nahhao74/Two-Wheels-Differential-Balance-Using-ROS2/solidwork/stm32f407-vet6-1.snapshot.2/stm32f407.jpg

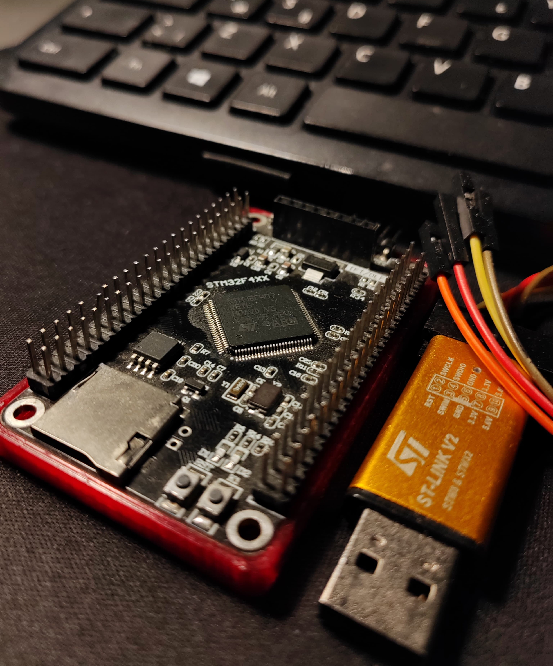
solidwork/stm32f407-vet6-1.snapshot.2/stm32f407.jpg
