nahhao74/Two-Wheels-Differential-Balance-Using-ROS2/README.md

# Two-Wheels-Differential-Balance-Using-ROS2
