nahhao74/Two-Wheels-Differential-Balance-Using-ROS2/imgs/twowheels_model.png

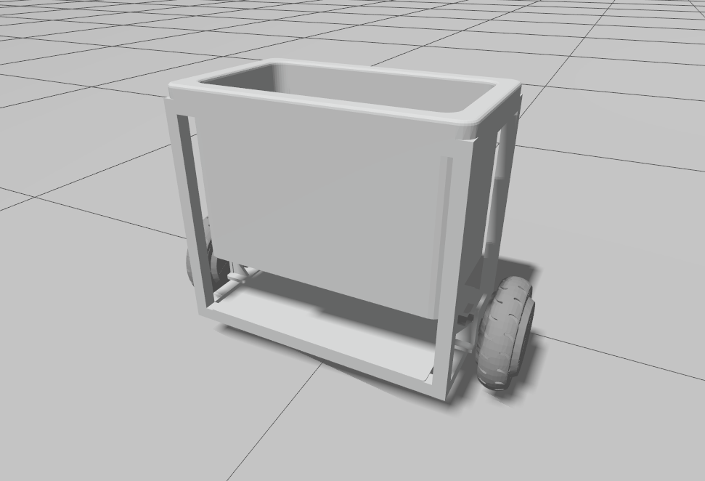
imgs/twowheels_model.png
