nahhao74/Two-Wheels-Differential-Balance-Using-ROS2/solidwork/zltech-zllg65asm250-v1-0-1.snapshot.4/messageImage_1767432714419.jpg

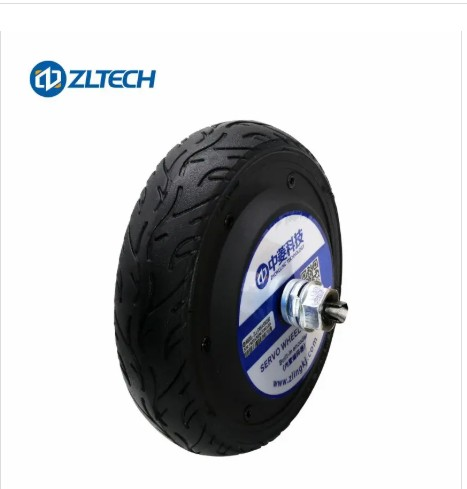
solidwork/zltech-zllg65asm250-v1-0-1.snapshot.4/messageImage_1767432714419.jpg
