nahhao74/Two-Wheels-Differential-Balance-Using-ROS2/solidwork/zltech-zllg65asm250-v1-0-1.snapshot.4/ZLLG65ASM250-V1.0.jpg

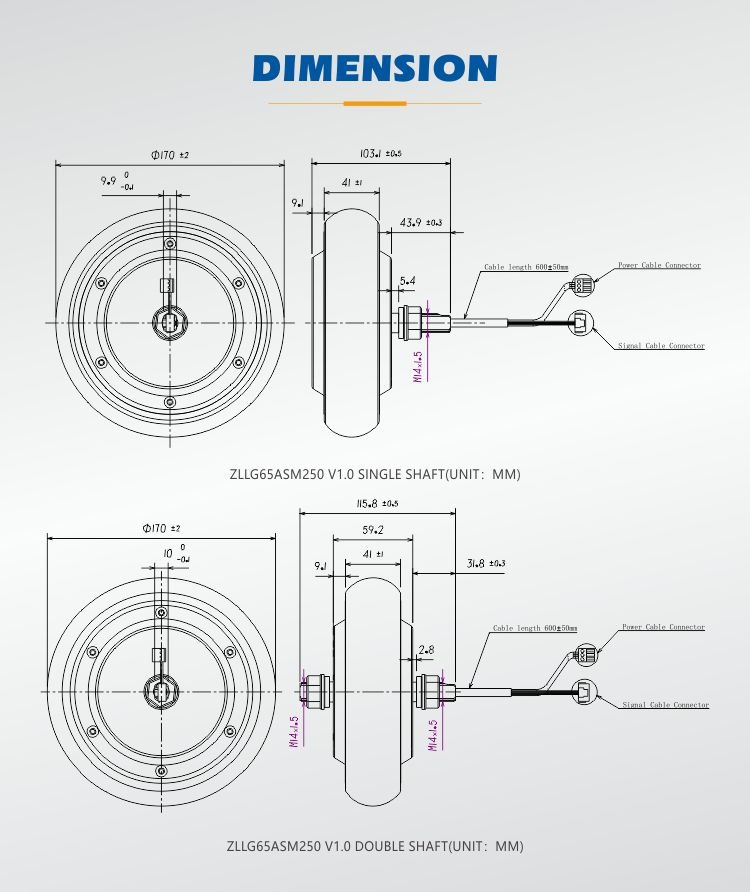
solidwork/zltech-zllg65asm250-v1-0-1.snapshot.4/ZLLG65ASM250-V1.0.jpg
