nahhao74/Two-Wheels-Differential-Balance-Using-ROS2/solidwork/zltech-zllg65asm250-v1-0-1.snapshot.4/ZLLG65ASM250 V1.0 DOUBLE SHAFT.STEP

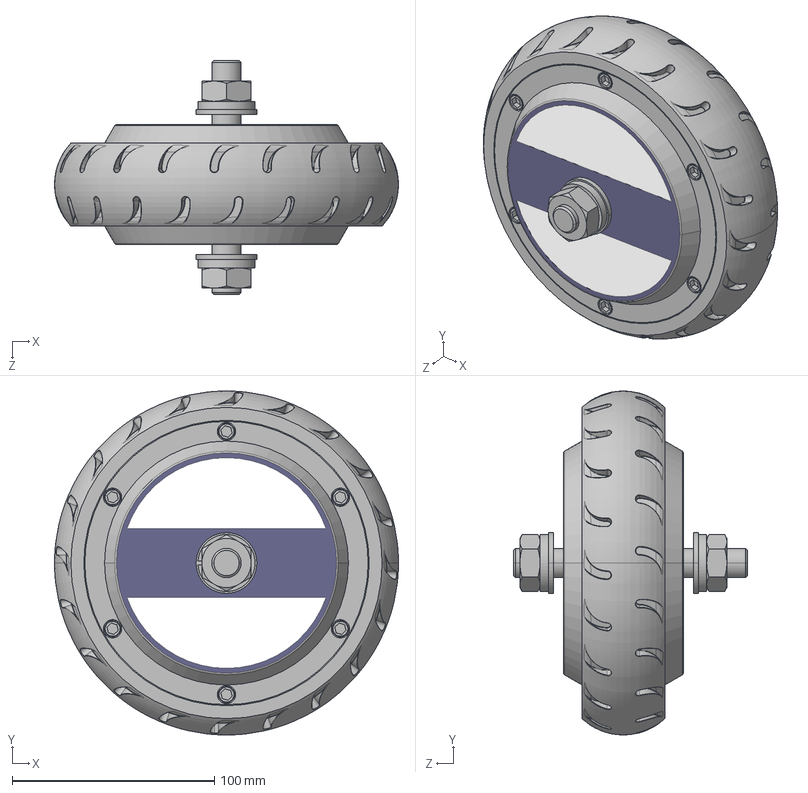
[picture p21: CAD file, 2026-07-22]
solidwork/zltech-zllg65asm250-v1-0-1.snapshot.4/ZLLG65ASM250 V1.0 DOUBLE SHAFT.STEP
170.0 x 170.0 x 115.8 mm
