nahhao74/Two-Wheels-Differential-Balance-Using-ROS2/solidwork/Cum_gia_do_khay.SLDASM

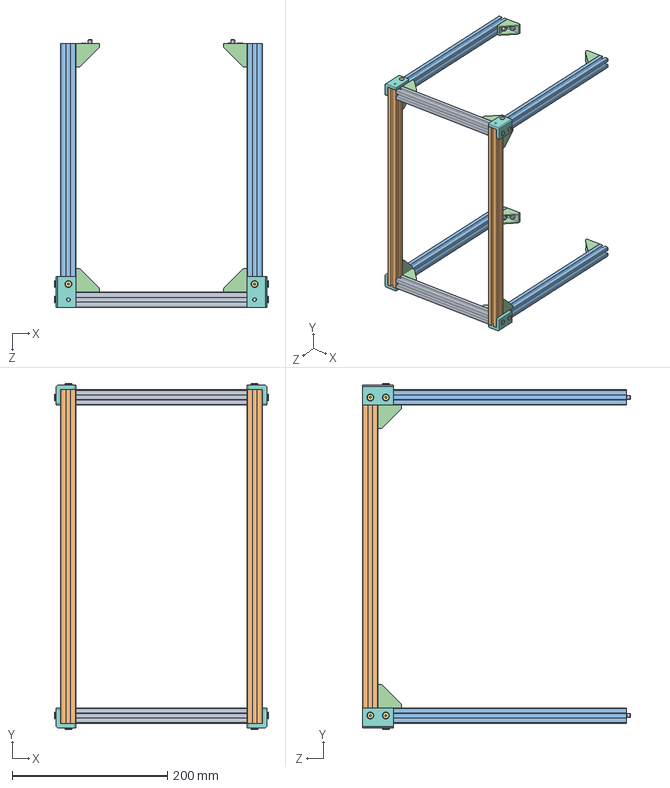
[picture p22: CAD file, 2026-07-22]
solidwork/Cum_gia_do_khay.SLDASM
276.0 x 446.0 x 345.3 mm
HFS5-2020-220 x 2
HFS5-2020-430 x 2
HFS5-2020-380 x 4
BRACKET_HBLFSN5 x 12
HNTT5-5 x 32
CSH-STU-M5-10 x 23
CBSTSE5-12 x 12
flat_bar x 4
