nahhao74/Two-Wheels-Differential-Balance-Using-ROS2/solidwork/zltech-zllg65asm250-v1-0-1.snapshot.4/ZLLG65ASM250 V1.0 SINGLE SHAFT.STEP

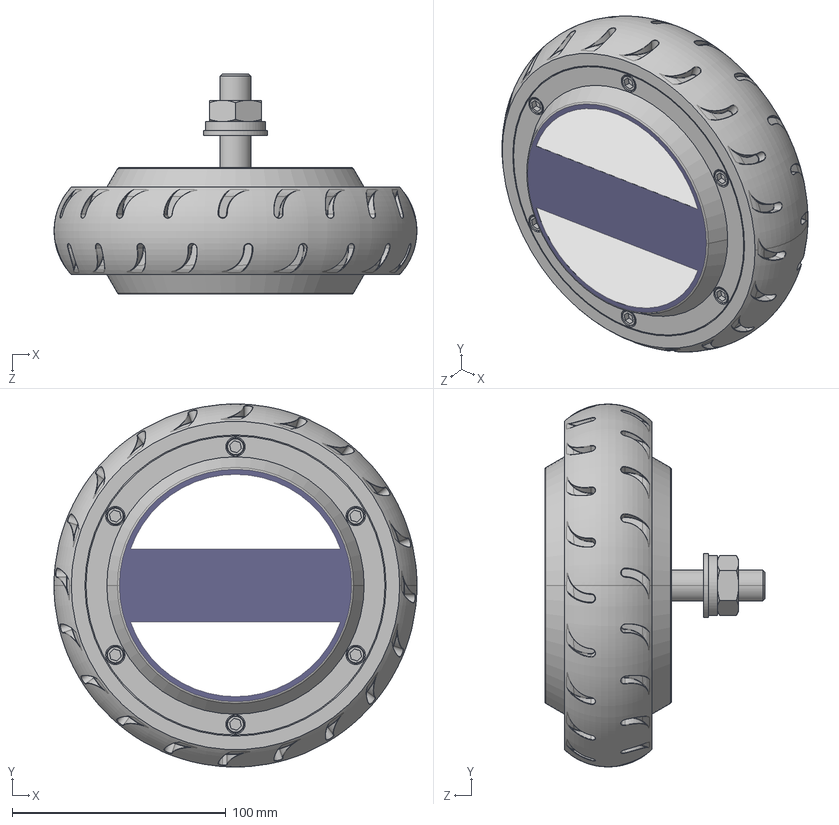
[picture p23: CAD file, 2026-07-22]
solidwork/zltech-zllg65asm250-v1-0-1.snapshot.4/ZLLG65ASM250 V1.0 SINGLE SHAFT.STEP
170.0 x 170.0 x 103.1 mm
