nahhao74/Two-Wheels-Differential-Balance-Using-ROS2/solidwork/HBLFSN5_SOLIDWORKS/HBLFSN5.SLDASM

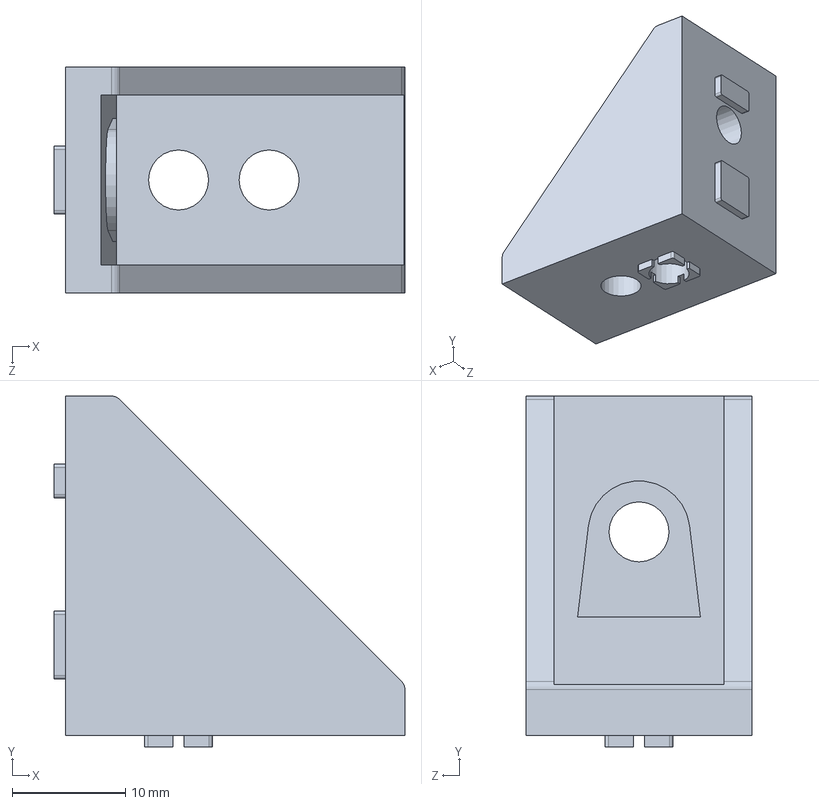
[picture p24: CAD file, 2026-07-22]
solidwork/HBLFSN5_SOLIDWORKS/HBLFSN5.SLDASM
31.0 x 31.0 x 20.0 mm
