nahhao74/Two-Wheels-Differential-Balance-Using-ROS2/solidwork/Cum_driver.SLDASM

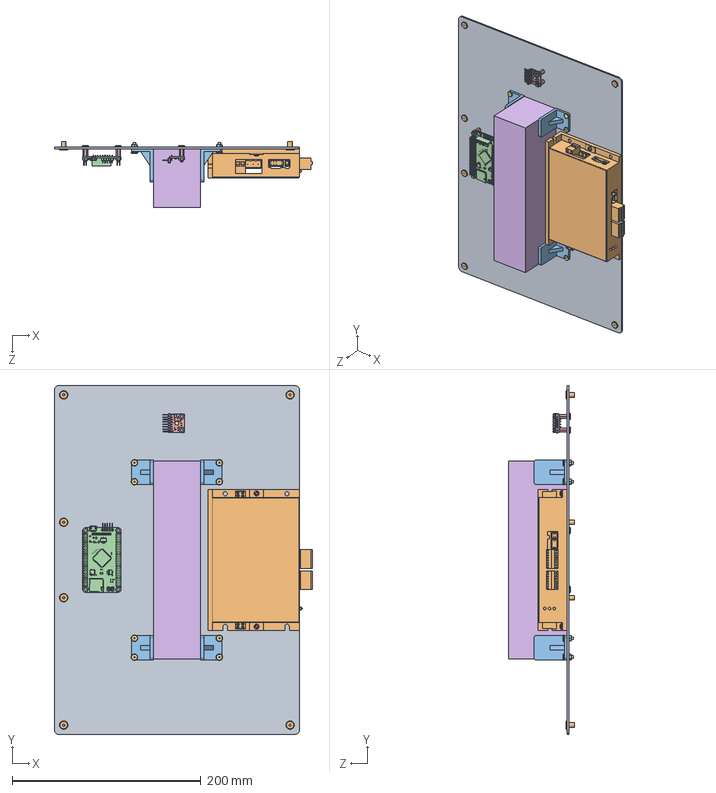
[picture p25: CAD file, 2026-07-22]
solidwork/Cum_driver.SLDASM
274.0 x 370.0 x 69.5 mm
base_plate
ZLAC8015D
Ga_do_pin x 4
stm32f4xx
stand_off_m3 x 6
SOT95P295X145-5N.stp
QFN50P395X395X90-25T265X255N.stp
CHIP-LED0603.stp
HDRRA8W64P254_1X8_2032X254X556B.stp
C0402.stp x 5
C0603.stp x 2
R0402.stp x 4
Board.stp
pin
CBSTSE3-10 x 8
SLBNL3 x 14
CBSTSE3-5 x 6
CBSTSE5-8 x 6
