nahhao74/Two-Wheels-Differential-Balance-Using-ROS2/solidwork/Khung_day.SLDASM

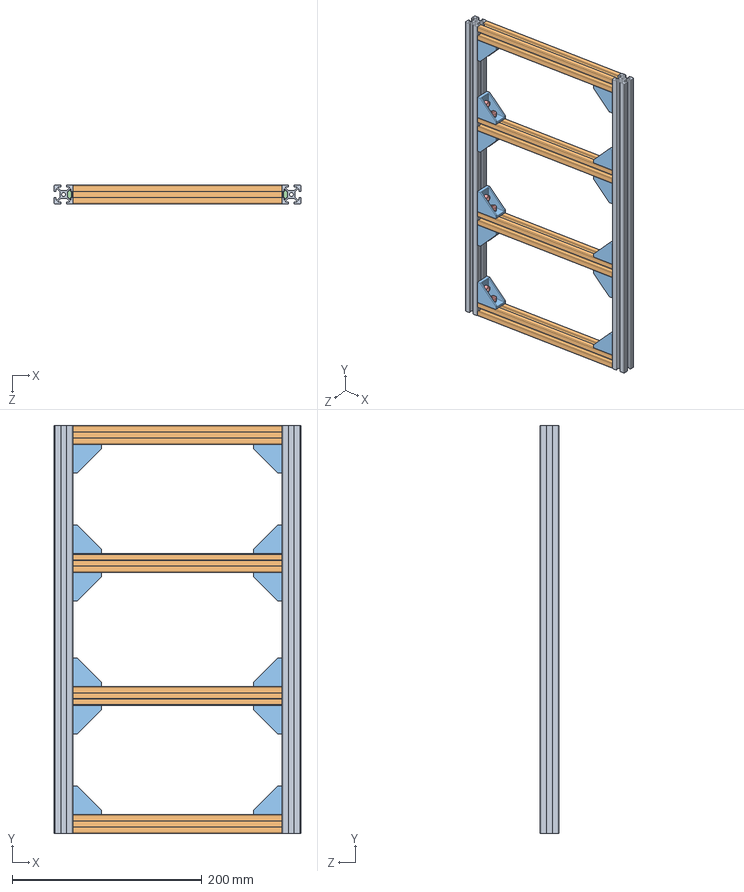
[picture p26: CAD file, 2026-07-22]
solidwork/Khung_day.SLDASM
260.0 x 430.0 x 20.0 mm
HFS5-2020-430 x 2
HFS5-2020-220 x 4
BRACKET_HBLFSN5 x 12
HNTT5-5 x 24
CSH-STU-M5-10 x 24
