nahhao74/Two-Wheels-Differential-Balance-Using-ROS2/solidwork/Cum_dong_co.SLDASM

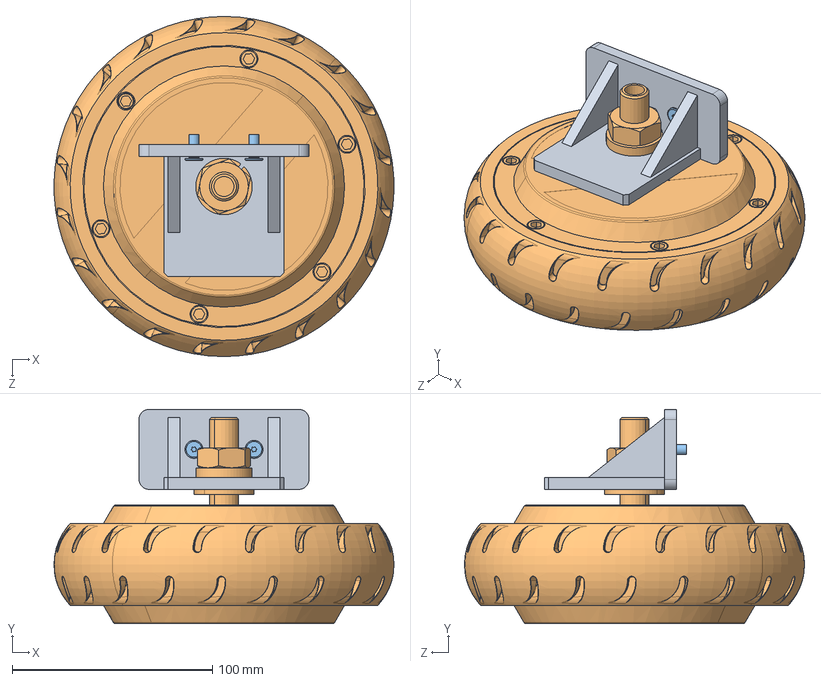
[picture p27: CAD file, 2026-07-22]
solidwork/Cum_dong_co.SLDASM
169.9 x 107.1 x 170.0 mm
Ga_do_motor
ZLLG65ASM250 V1.0 SINGLE SHAFT
CBSTSE5-12 x 2
