nahhao74/Two-Wheels-Differential-Balance-Using-ROS2/Robot_sim_ws/2_wheels/meshes/base_link.STL

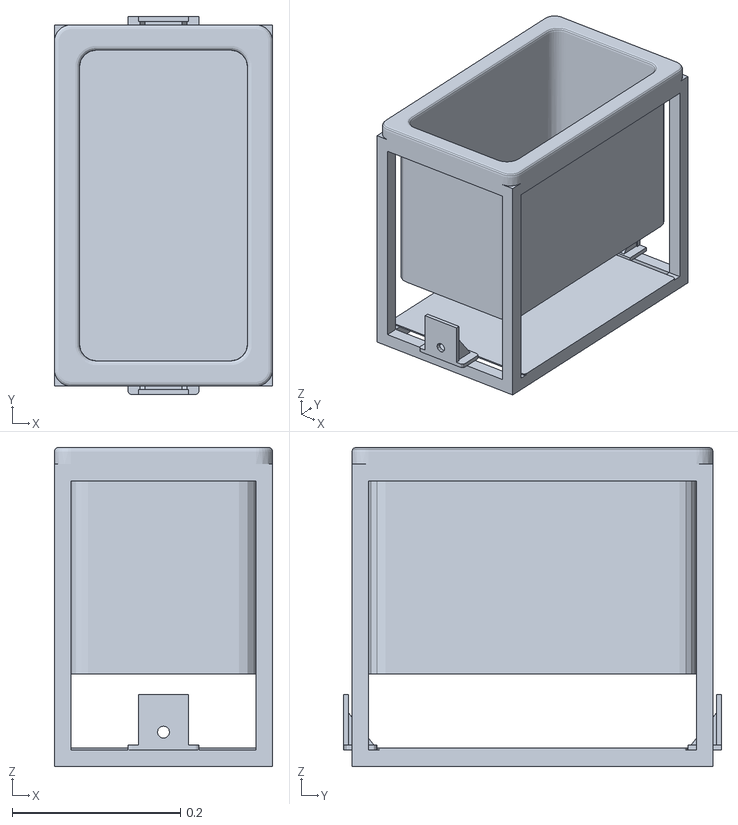
[picture p28: CAD file, 2026-06-26]
Robot_sim_ws/2_wheels/meshes/base_link.STL
0.26 x 0.45 x 0.38
