nahhao74/Two-Wheels-Differential-Balance-Using-ROS2/solidwork/CBSTSE3-10_SOLIDWORKS/CBSTSE3-10.SLDPRT

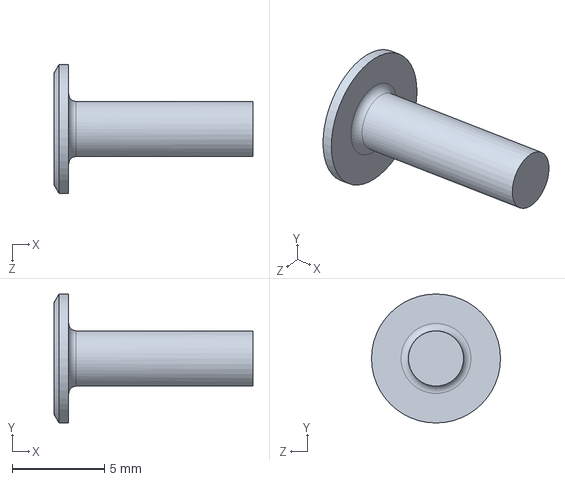
[picture p29: CAD file, 2026-07-22]
solidwork/CBSTSE3-10_SOLIDWORKS/CBSTSE3-10.SLDPRT
10.8 x 7.00 x 7.00 mm
