nahhao74/Two-Wheels-Differential-Balance-Using-ROS2/solidwork/CBSTSE3-5_SOLIDWORKS/CBSTSE3-5.SLDPRT

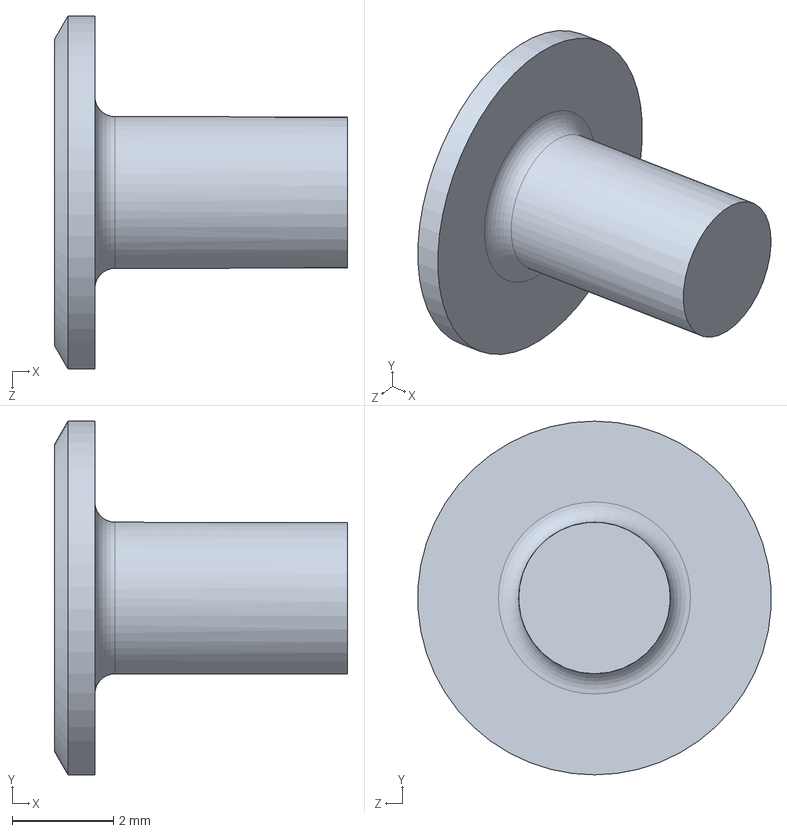
[picture p30: CAD file, 2026-07-22]
solidwork/CBSTSE3-5_SOLIDWORKS/CBSTSE3-5.SLDPRT
5.80 x 7.00 x 6.99 mm
