nahhao74/Two-Wheels-Differential-Balance-Using-ROS2/solidwork/CBSTSE5-12_SOLIDWORKS/CBSTSE5-12.SLDPRT

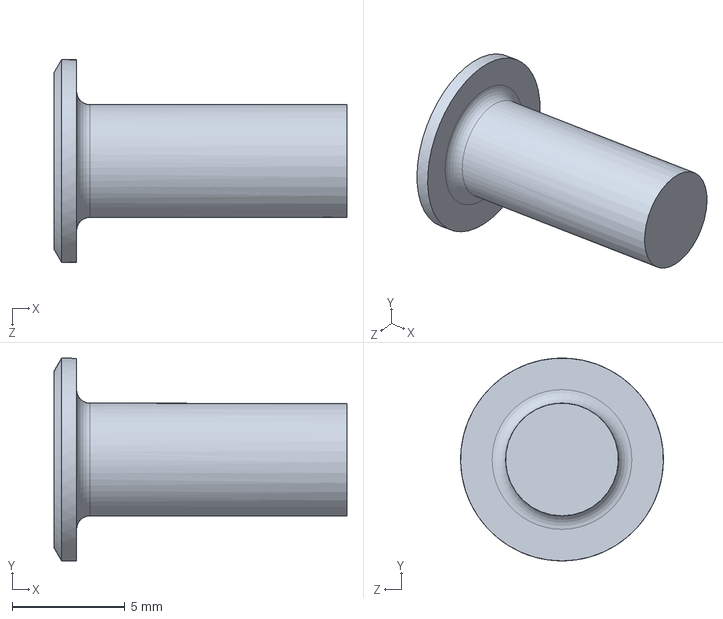
[picture p31: CAD file, 2026-07-22]
solidwork/CBSTSE5-12_SOLIDWORKS/CBSTSE5-12.SLDPRT
13.0 x 9.00 x 8.99 mm
