nahhao74/Two-Wheels-Differential-Balance-Using-ROS2/solidwork/CBSTSE5-8_SOLIDWORKS/CBSTSE5-8.SLDPRT

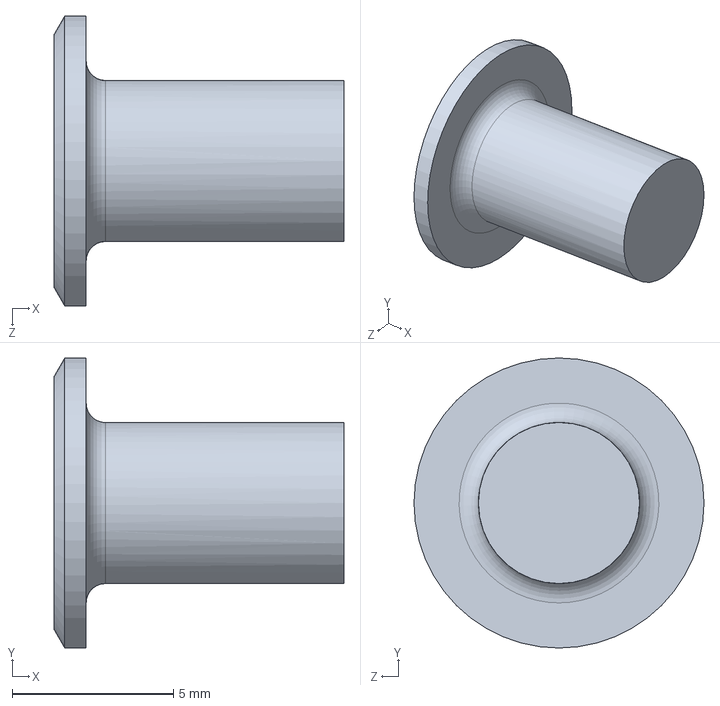
[picture p32: CAD file, 2026-07-22]
solidwork/CBSTSE5-8_SOLIDWORKS/CBSTSE5-8.SLDPRT
9.00 x 9.00 x 9.00 mm
