nahhao74/Two-Wheels-Differential-Balance-Using-ROS2/solidwork/CSH-STU-M5-10_SolidWorks_07/CSH-STU-M5-10.SLDPRT

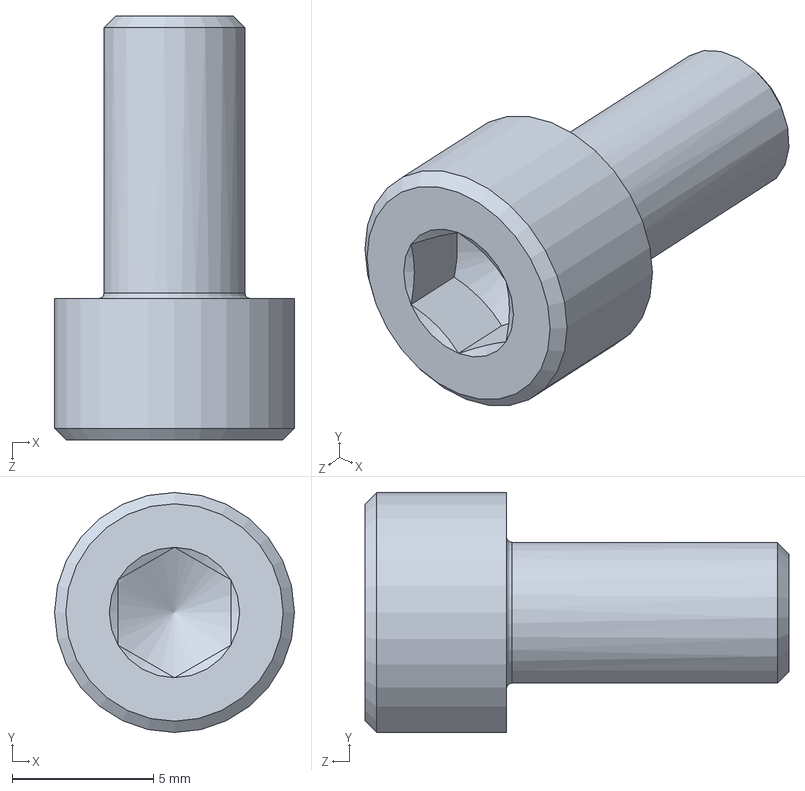
[picture p33: CAD file, 2026-07-22]
solidwork/CSH-STU-M5-10_SolidWorks_07/CSH-STU-M5-10.SLDPRT
8.50 x 8.50 x 15.0 mm
