nahhao74/Two-Wheels-Differential-Balance-Using-ROS2/solidwork/flat_bar.SLDPRT

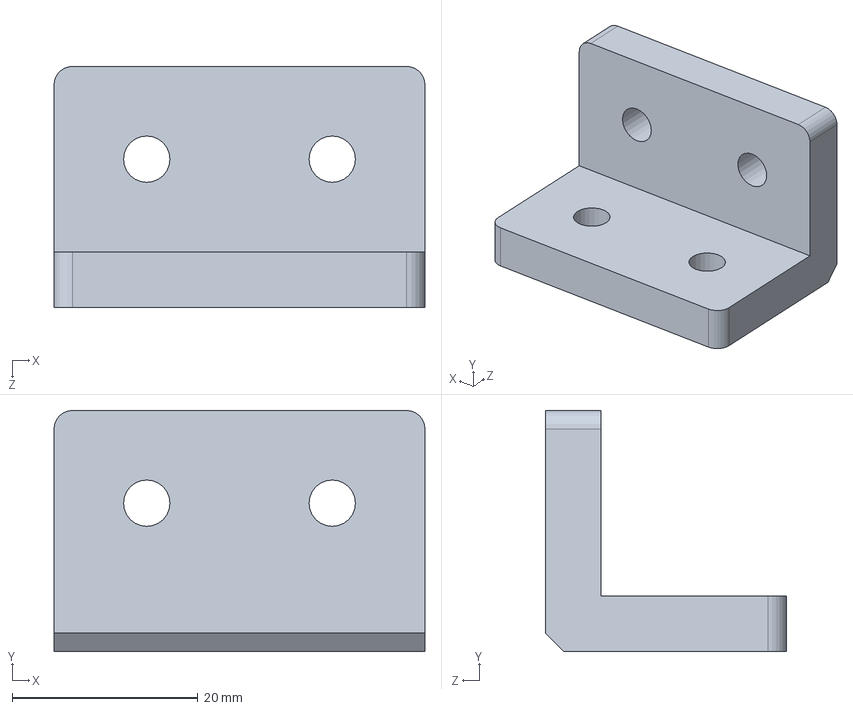
[picture p34: CAD file, 2026-07-22]
solidwork/flat_bar.SLDPRT
40.0 x 26.0 x 26.0 mm
