nahhao74/Two-Wheels-Differential-Balance-Using-ROS2/solidwork/HFS5-2020-140_SOLIDWORKS/HFS5-2020-140.SLDPRT

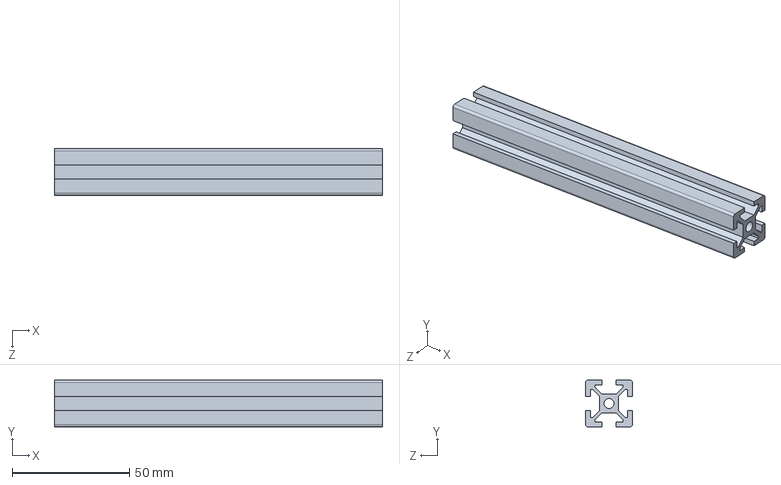
[picture p35: CAD file, 2026-07-22]
solidwork/HFS5-2020-140_SOLIDWORKS/HFS5-2020-140.SLDPRT
140.0 x 20.0 x 20.0 mm
