nahhao74/Two-Wheels-Differential-Balance-Using-ROS2/solidwork/HFS5-2020-170_SOLIDWORKS/HFS5-2020-170.SLDPRT

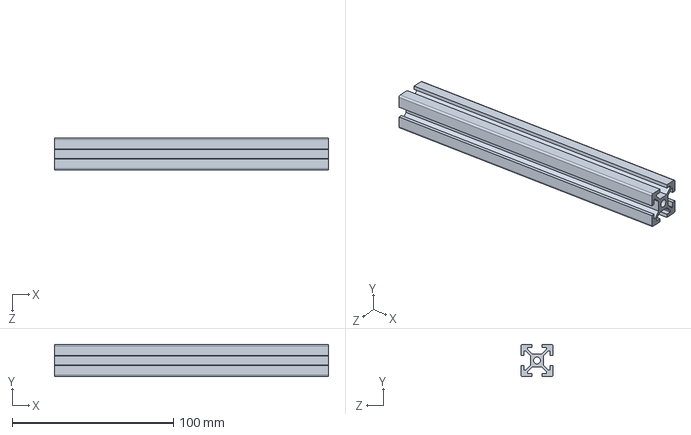
[picture p36: CAD file, 2026-07-22]
solidwork/HFS5-2020-170_SOLIDWORKS/HFS5-2020-170.SLDPRT
170.0 x 20.0 x 20.0 mm
