nahhao74/Two-Wheels-Differential-Balance-Using-ROS2/solidwork/HFS5-2020-220_SOLIDWORKS/HFS5-2020-220.SLDPRT

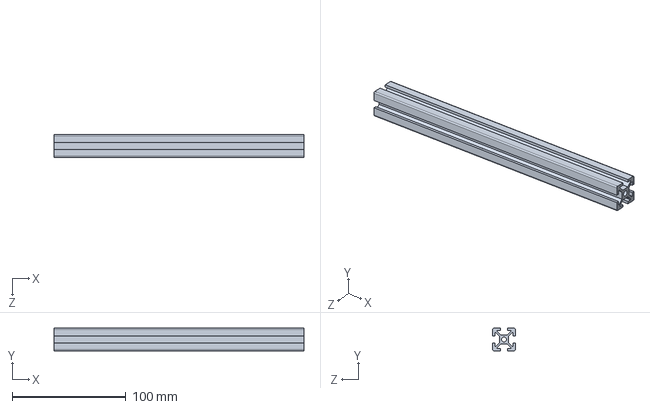
[picture p37: CAD file, 2026-07-22]
solidwork/HFS5-2020-220_SOLIDWORKS/HFS5-2020-220.SLDPRT
220.0 x 20.0 x 20.0 mm
