nahhao74/Two-Wheels-Differential-Balance-Using-ROS2/solidwork/HFS5-2020-380_SOLIDWORKS/HFS5-2020-380.SLDPRT

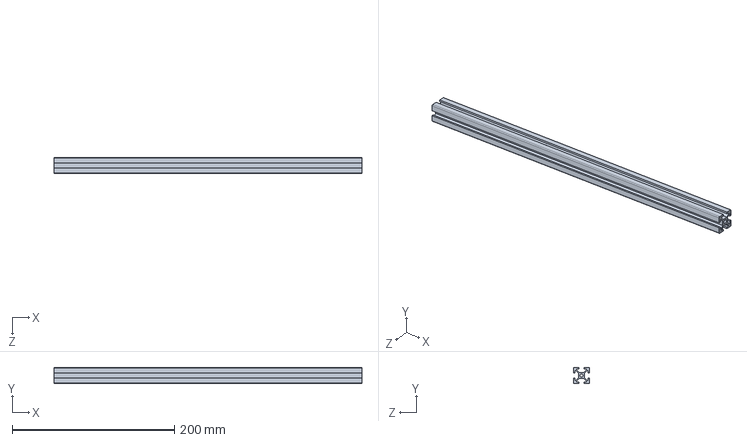
[picture p38: CAD file, 2026-07-22]
solidwork/HFS5-2020-380_SOLIDWORKS/HFS5-2020-380.SLDPRT
380.0 x 20.0 x 20.0 mm
