nahhao74/Two-Wheels-Differential-Balance-Using-ROS2/solidwork/HFS5-2020-430_SOLIDWORKS/HFS5-2020-430.SLDPRT

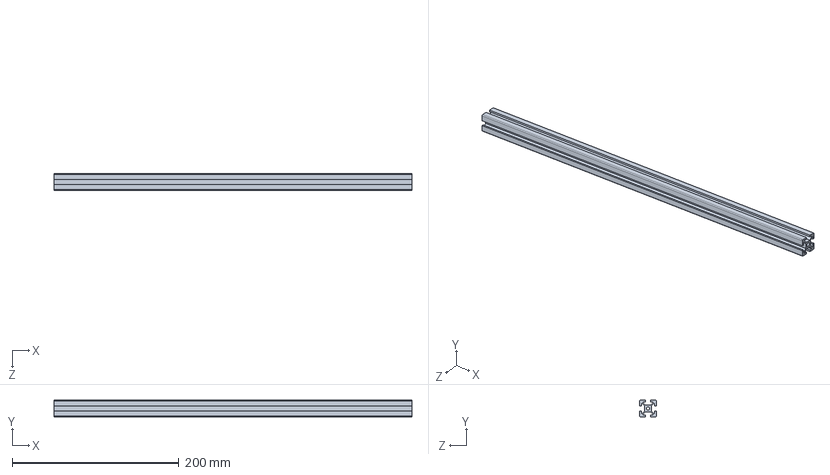
[picture p39: CAD file, 2026-07-22]
solidwork/HFS5-2020-430_SOLIDWORKS/HFS5-2020-430.SLDPRT
430.0 x 20.0 x 20.0 mm
