nahhao74/Two-Wheels-Differential-Balance-Using-ROS2/solidwork/SLBNL3_SOLIDWORKS/SLBNL3.SLDPRT

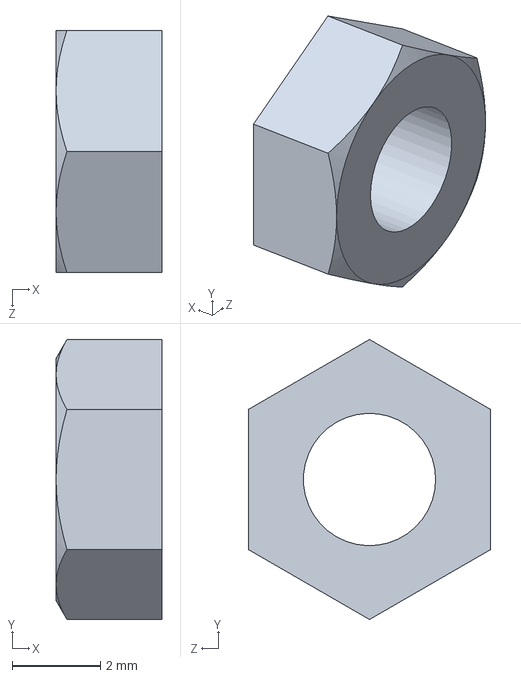
[picture p40: CAD file, 2026-07-22]
solidwork/SLBNL3_SOLIDWORKS/SLBNL3.SLDPRT
2.40 x 6.35 x 5.50 mm
