nahhao74/Two-Wheels-Differential-Balance-Using-ROS2/solidwork/stm32f407-vet6-1.snapshot.2/stm32f4xx.SLDPRT

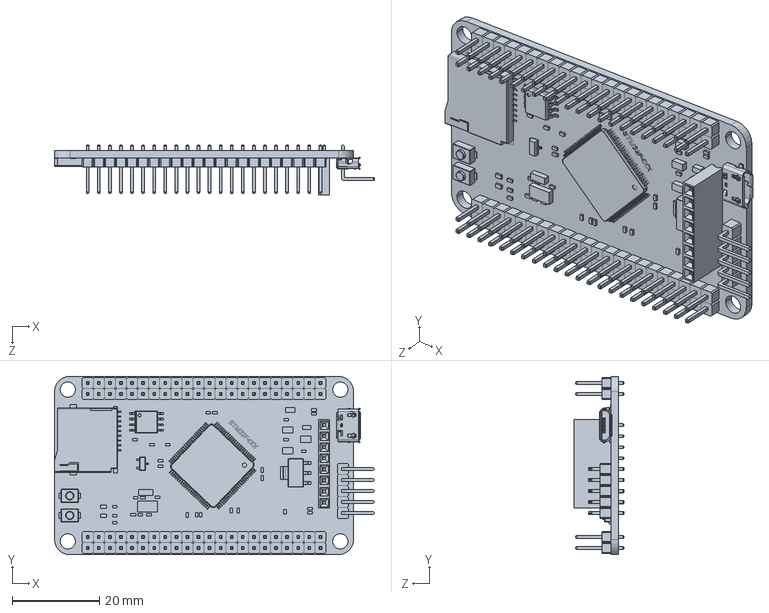
[picture p41: CAD file, 2026-07-22]
solidwork/stm32f407-vet6-1.snapshot.2/stm32f4xx.SLDPRT
73.4 x 40.9 x 11.5 mm
