nahhao74/Two-Wheels-Differential-Balance-Using-ROS2/solidwork/User Library-GY-521-1/User Library-GY-521-1.SLDPRT

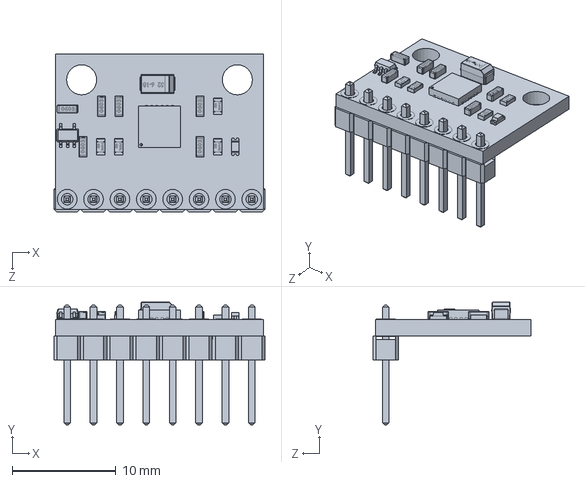
[picture p42: CAD file, 2026-07-22]
solidwork/User Library-GY-521-1/User Library-GY-521-1.SLDPRT
20.3 x 11.8 x 15.2 mm
