nahhao74/Two-Wheels-Differential-Balance-Using-ROS2/solidwork/zlac8015d-1.snapshot.1/ZLAC8015D.SLDPRT

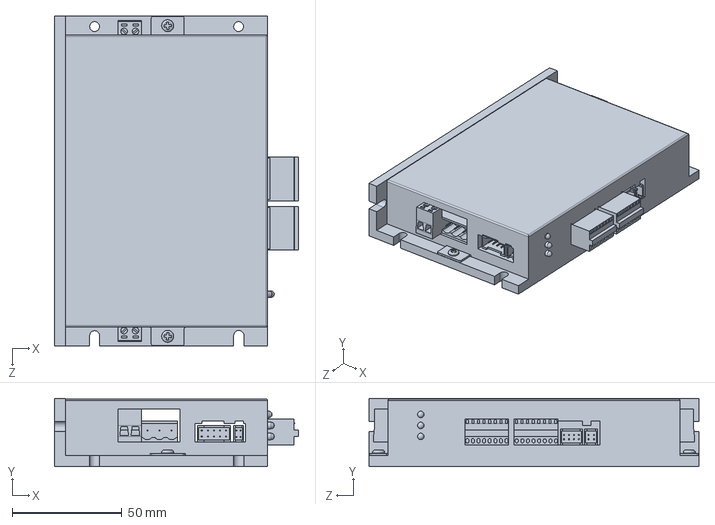
[picture p43: CAD file, 2026-07-22]
solidwork/zlac8015d-1.snapshot.1/ZLAC8015D.SLDPRT
111.0 x 31.0 x 150.0 mm
