nahhao74/Two-Wheels-Differential-Balance-Using-ROS2/Robot_sim_ws/2_wheels/meshes/left_wheel_Link.STL

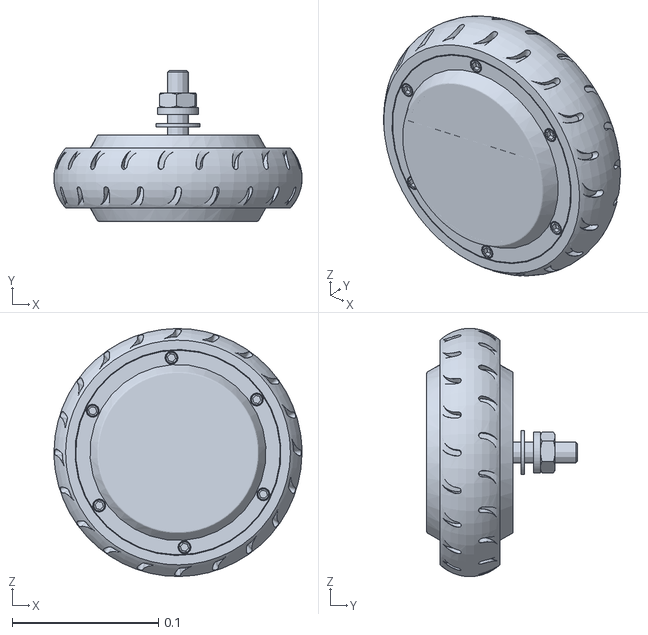
[picture p44: CAD file, 2026-06-26]
Robot_sim_ws/2_wheels/meshes/left_wheel_Link.STL
0.17 x 0.103 x 0.17
