nahhao74/Two-Wheels-Differential-Balance-Using-ROS2/solidwork/HBLFSN5_SOLIDWORKS/BRACKET_HBLFSN5.SLDPRT

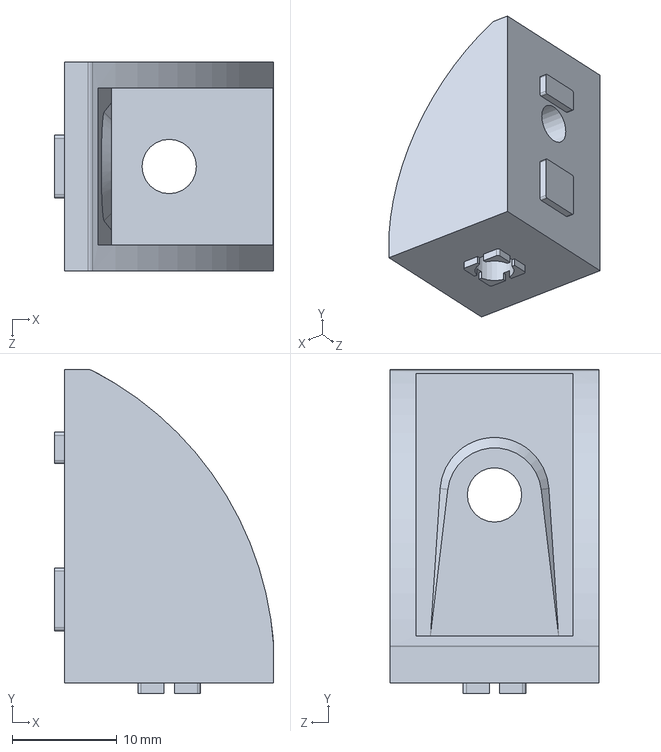
[picture p45: CAD file, 2026-07-22]
solidwork/HBLFSN5_SOLIDWORKS/BRACKET_HBLFSN5.SLDPRT
21.0 x 31.0 x 20.0 mm
