nahhao74/Two-Wheels-Differential-Balance-Using-ROS2/solidwork/Ga_do_pin.SLDPRT

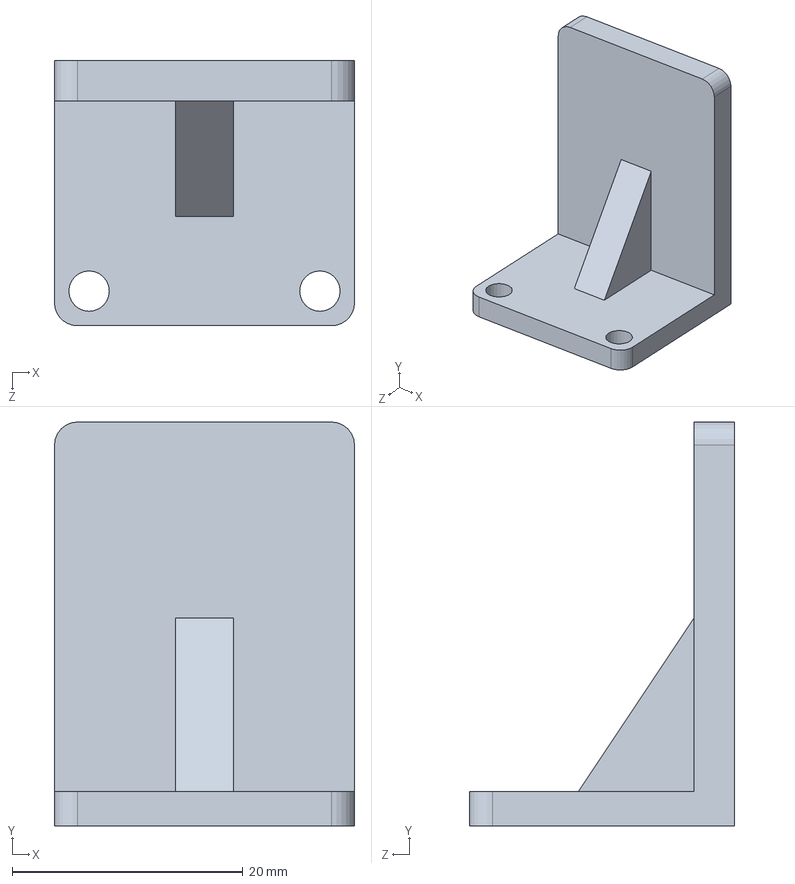
[picture p46: CAD file, 2026-07-22]
solidwork/Ga_do_pin.SLDPRT
26.0 x 35.0 x 23.0 mm
