nahhao74/Two-Wheels-Differential-Balance-Using-ROS2/solidwork/Ga_do_motor.SLDPRT

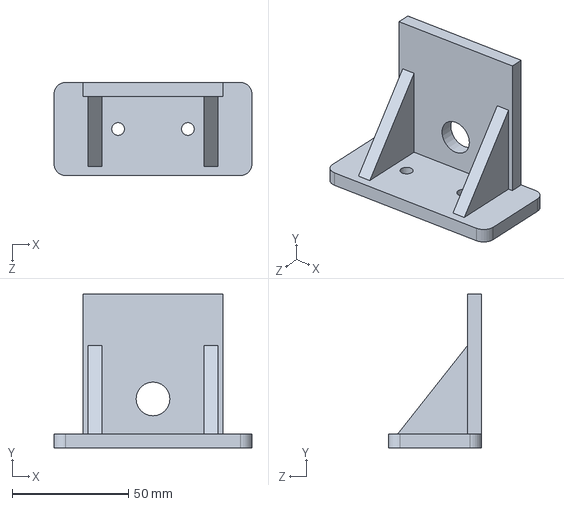
[picture p47: CAD file, 2026-07-22]
solidwork/Ga_do_motor.SLDPRT
85.0 x 66.0 x 40.0 mm
