nahhao74/Two-Wheels-Differential-Balance-Using-ROS2/solidwork/khay.SLDPRT

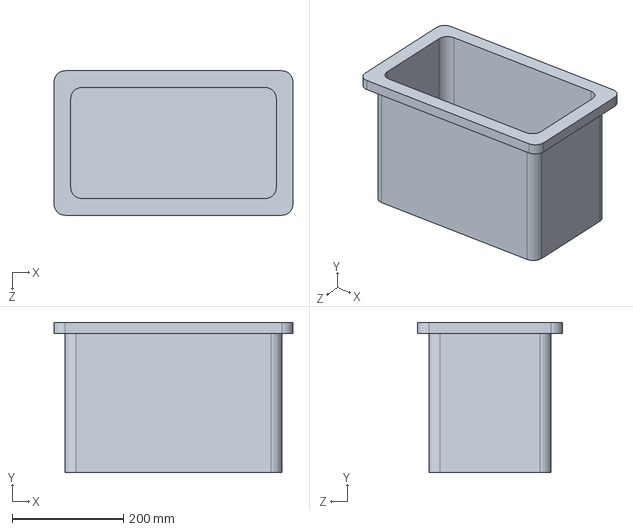
[picture p48: CAD file, 2026-07-22]
solidwork/khay.SLDPRT
430.0 x 270.0 x 260.0 mm
