nahhao74/Two-Wheels-Differential-Balance-Using-ROS2/solidwork/hopche.SLDPRT

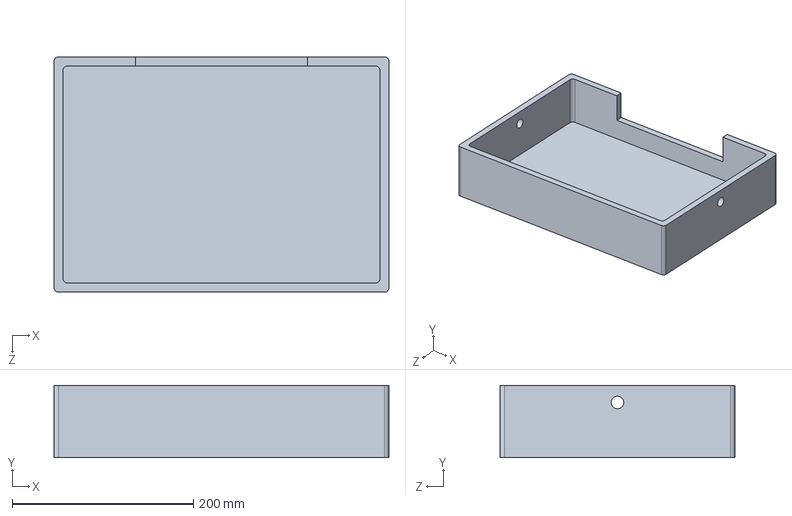
[picture p49: CAD file, 2026-07-22]
solidwork/hopche.SLDPRT
370.0 x 80.0 x 260.0 mm
