nahhao74/Two-Wheels-Differential-Balance-Using-ROS2/(list of files, cad)

Other CAD files:
solidwork/HBLFSN5_SOLIDWORKS/NAT_HBLFSN5.SLDPRT
solidwork/WSSS25-15-5_SolidWorks_(Native)_=2015_20260524/WSSS25-15-5.sldprt
Robot_sim_ws/2_wheels/meshes/right_wheel_Link.STL
solidwork/zltech-zllg65asm250-v1-0-1.snapshot.4/ZLLG65ASM250 V1.0 SINGLE SHAFT.SLDPRT
